aloksethi/elephant_clock/README.md

# elephant_clock
four digit clock

## Hardware
* two 7-seg displays for hours and two 7-seg displays for minutes.
* two switches along with debounce ckt.
* one green LED in middle of hours and minutes segments.
* rpi-pico is the brains.
