aloksethi/elephant_clock/pcb/clock/clock.kicad_pcb

## KiCad design pcb/clock/clock.kicad_pcb (2023-06-15)

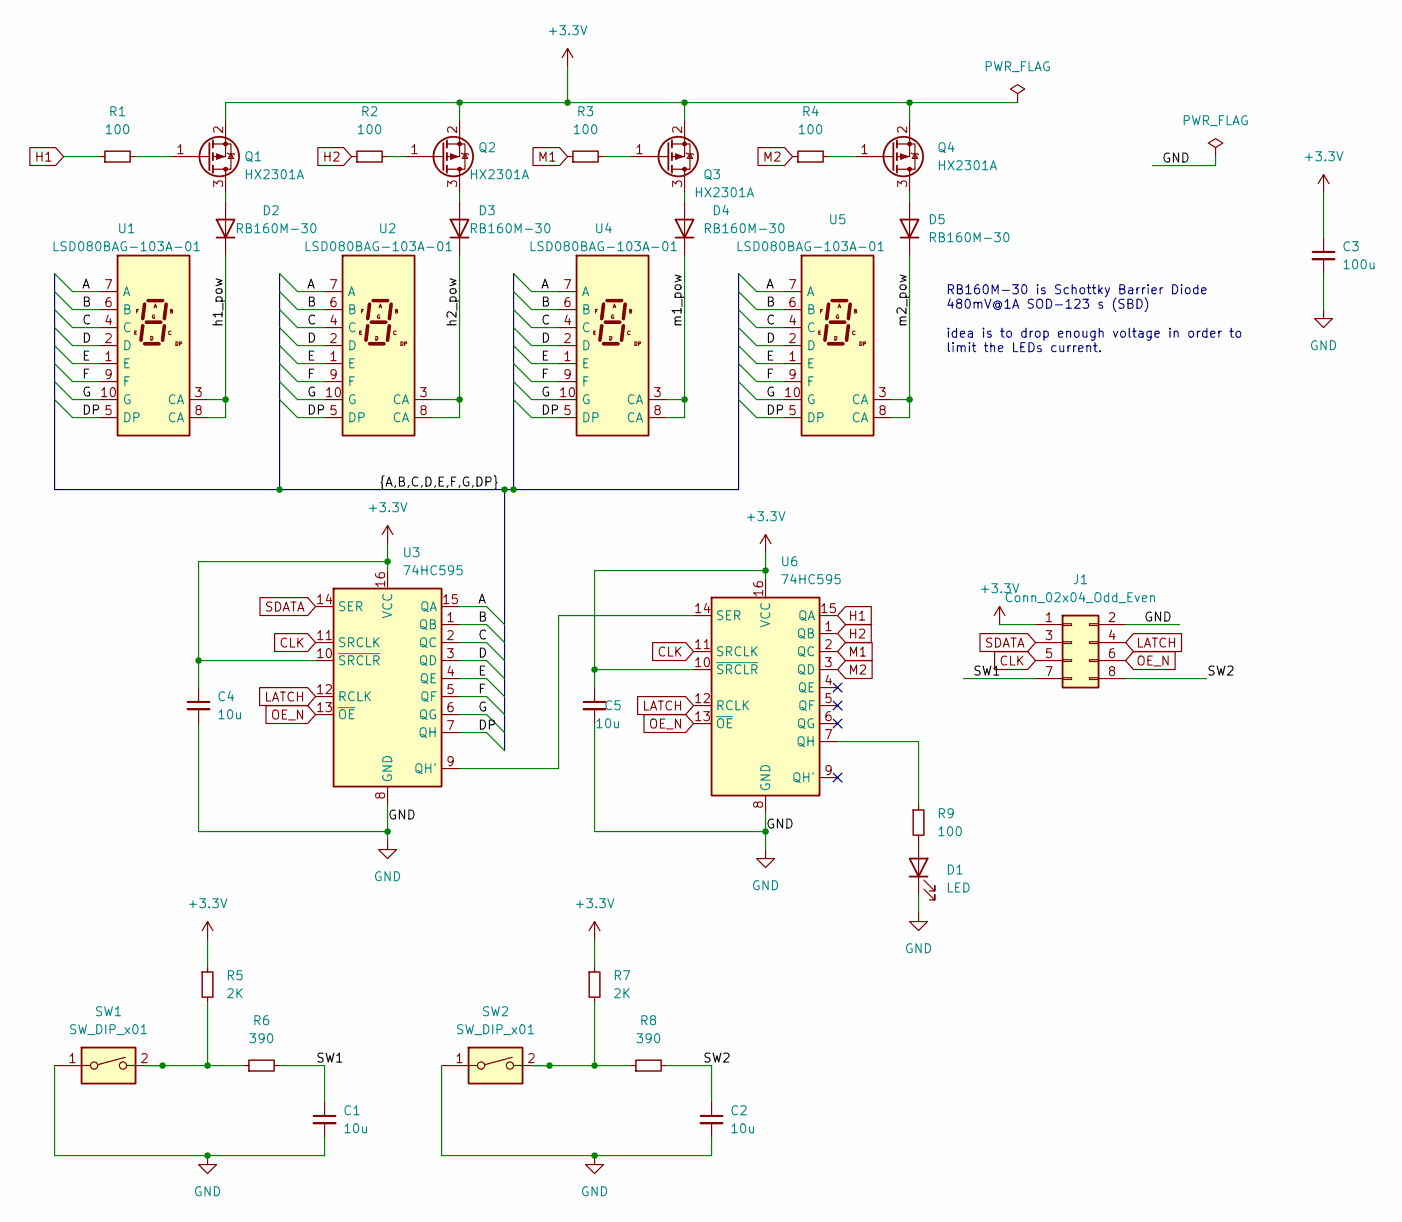
[picture p1: schematic clock.kicad_sch, clock face]

Parts:
C1, C2, C4, C5: 10u; C_0805_2012Metric_Pad1.18x1.45mm_HandSolder
C3: 100u; CP_Elec_8x10.5
D1: LED; LED_0805_2012Metric_Pad1.15x1.40mm_HandSolder
D2, D3, D4, D5: RB160M-30; D_SOD-123
J1: Conn_02x04_Odd_Even; PinHeader_2x04_P2.54mm_Vertical_SMD
Q1, Q2, Q3, Q4: HX2301A; SOT-23_Handsoldering
R1, R2, R3, R4: 100; R_0603_1608Metric_Pad0.98x0.95mm_HandSolder
R5, R7: 2K; R_0805_2012Metric_Pad1.20x1.40mm_HandSolder
R6, R8: 390; R_0805_2012Metric_Pad1.20x1.40mm_HandSolder
R9: 100; R_0805_2012Metric_Pad1.20x1.40mm_HandSolder
SW1, SW2: SW_DIP_x01; SW_SPST_lcsc_c174049
U1, U2, U4, U5: LSD080BAG-103A-01; 7SegmentLED_lsd080bag-103a
U3: 74HC595; SOIC-16_3.9x9.9mm_P1.27mm_handsolder
U6: 74HC595; SOIC-16_3.9x9.9mm_P1.27mm

Connections:
+3V3: C3.1, C4.1, C5.1, J1.1, Q1.2 (S), Q2.2 (S), Q3.2 (S), Q4.2 (S), R5.1, R7.1, U3.10 (~SRCLR), U3.16 (VCC), U6.10 (~SRCLR), U6.16 (VCC)
/A: U1.7 (A), U2.7 (A), U3.15 (QA), U4.7 (A), U5.7 (A)
/B: U1.6 (B), U2.6 (B), U3.1 (QB), U4.6 (B), U5.6 (B)
/C: U1.4 (C), U2.4 (C), U3.2 (QC), U4.4 (C), U5.4 (C)
/D: U1.2 (D), U2.2 (D), U3.3 (QD), U4.2 (D), U5.2 (D)
/DP: U1.5 (DP), U2.5 (DP), U3.7 (QH), U4.5 (DP), U5.5 (DP)
/E: U1.1 (E), U2.1 (E), U3.4 (QE), U4.1 (E), U5.1 (E)
/F: U1.9 (F), U2.9 (F), U3.5 (QF), U4.9 (F), U5.9 (F)
/G: U1.10 (G), U2.10 (G), U3.6 (QG), U4.10 (G), U5.10 (G)
/SW1: C1.1, J1.7, R6.2
/SW2: C2.1, J1.8, R8.2
/h1_pow: D2.1 (K), U1.3 (CA), U1.8 (CA)
/h2_pow: D3.1 (K), U2.3 (CA), U2.8 (CA)
/m1_pow: D4.1 (K), U4.3 (CA), U4.8 (CA)
/m2_pow: D5.1 (K), U5.3 (CA), U5.8 (CA)
CLK: J1.5, U3.11 (SRCLK), U6.11 (SRCLK)
GND: C1.2, C2.2, C3.2, C4.2, C5.2, D1.1 (K), J1.2, SW1.1, SW2.1, U3.8 (GND), U6.8 (GND)
H1: R1.1, U6.15 (QA)
H2: R2.1, U6.1 (QB)
LATCH: J1.4, U3.12 (RCLK), U6.12 (RCLK)
M1: R3.1, U6.2 (QC)
M2: R4.1, U6.3 (QD)
unnamed: D1.2 (A), R9.2
unnamed: Q1.1 (G), R1.2
unnamed: D2.2 (A), Q1.3 (D)
unnamed: Q2.1 (G), R2.2
unnamed: D3.2 (A), Q2.3 (D)
unnamed: Q3.1 (G), R3.2
unnamed: D4.2 (A), Q3.3 (D)
unnamed: Q4.1 (G), R4.2
unnamed: D5.2 (A), Q4.3 (D)
unnamed: R5.2, R6.1, SW1.2
unnamed: R7.2, R8.1, SW2.2
unnamed: R9.1, U6.7 (QH)
unnamed: U3.9 (QH'), U6.14 (SER)
OE_N: J1.6, U3.13 (~OE), U6.13 (~OE)
SDATA: J1.3, U3.14 (SER)

Notes on the sheet:
RB160M-30 is Schottky Barrier Diode 480mV@1A SOD-123 s (SBD) idea is to drop enough voltage in order to limit the LEDs current.

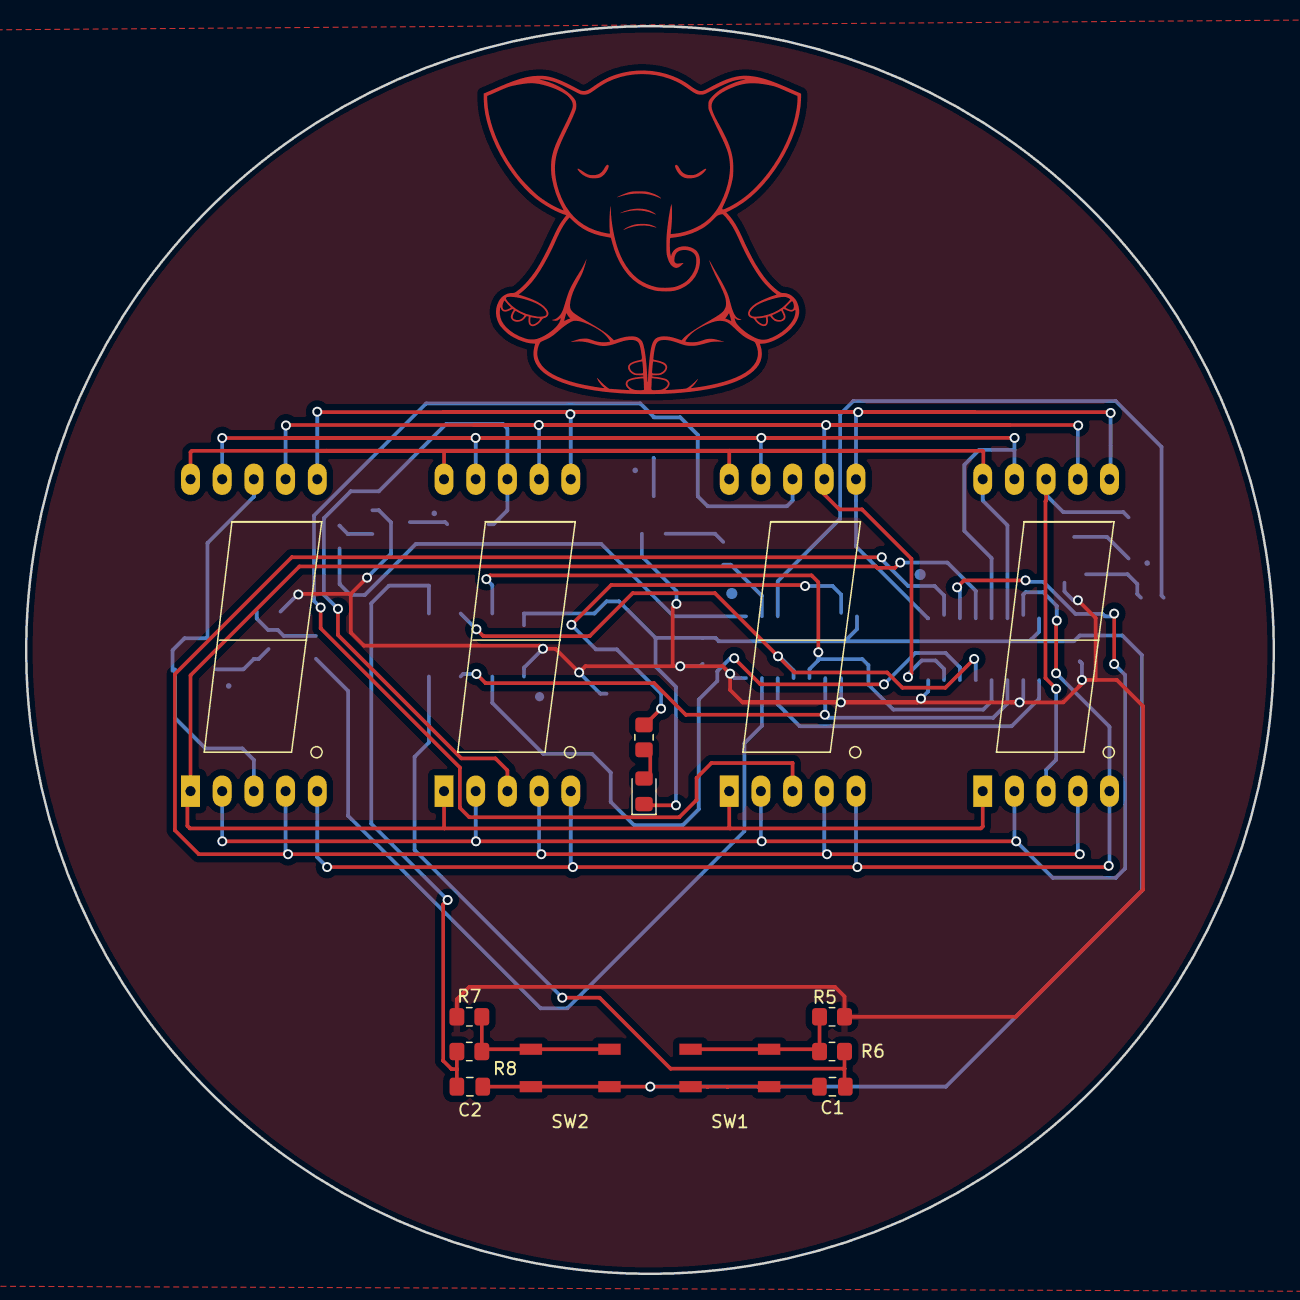
[picture p2: board clock.kicad_pcb from above]

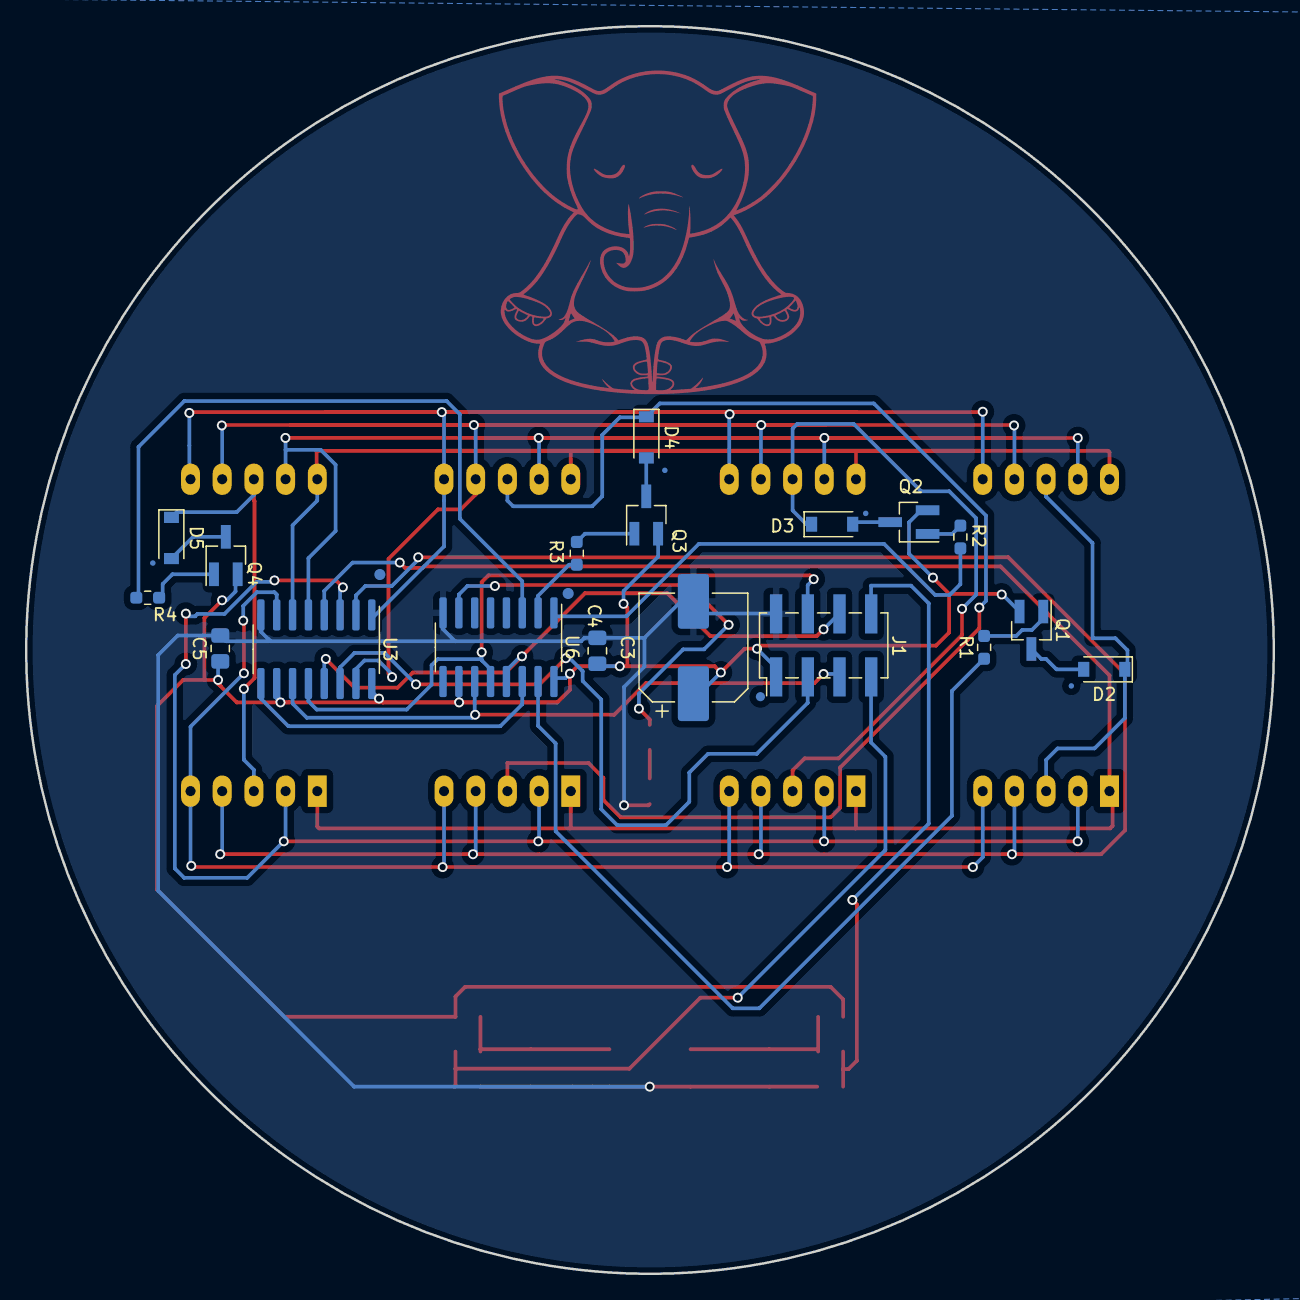
[picture p3: board clock.kicad_pcb from below]

Board: 2 copper layers, 100.0 x 100.0 mm, 32 parts (18 on the bottom side), 37 nets.
