aloksethi/elephant_clock/(threads)

Thread 2 (2023-05-07):

pin markers missing

aloksethi, 2023-05-07:
No marking on PCB indicating which side is pin 1

Thread 4 (2023-05-18):

update the footprint for the shift register

aloksethi, 2023-05-18:
hand soldering is difficult.
unfortunately there are smd components on both sides n since i assembled front first, didn;t managed to do good job on the back side.

Thread 7 (2023-05-18):

no current limit options

aloksethi, 2023-05-18:
right now there is no way to limit 7 seg current. two options exist
1) add a diode in series to power line for the 7 seg, thus dropping the voltage n so reducing the current.
2) add 8 resistors for each led.

shift register has limited current sink capability, so do check the numbers once again
