aloksethi/elephant_clock/(commit log)

2023-04-01 created an empty pcb
    [clock.kicad_pcb, clock.kicad_sch]
2023-04-01 started with schematic. still need buttons,power n other thigns.
    [clock.kicad_sch]
2023-04-03 hopefully a complete schematic with footprints allocated
    [clock.kicad_sch]
2023-04-04 fixed wrong symbol for the 7seg, D leg was shorted with E leg, added elephant logo. placement of 7 seg n switches
    [clock.kicad_pcb, clock.kicad_sch]
2023-04-15 added gerber files and bkup files
    [clock-B_Cu.gbr, clock-B_Mask.gbr, clock-B_Paste.gbr, clock-B_Silkscreen.gbr, clock-Edge_Cuts.gbr, clock-F_Cu.gbr, clock-F_Mask.gbr, clock-F_Paste.gbr]
2023-04-15 first complete pcb of the clock
    [clock.kicad_pcb, clock.kicad_sch]
2023-06-15 new version. tried to fix the busg in v1
    [clock.kicad_pcb, clock.kicad_sch]
2023-06-15 grbs files for the 2nd version
    [clock-B_Cu.gbr, clock-B_Mask.gbr, clock-B_Paste.gbr, clock-B_Silkscreen.gbr, clock-Edge_Cuts.gbr, clock-F_Cu.gbr, clock-F_Mask.gbr, clock-F_Paste.gbr]
2023-07-31 switches and time setting fucntionality are working
2025-01-01 added support of ds3231 module over i2c
